Fjgarc75-beep/Felix/docs/presentacion/presentacion-proyecto.pptx

## Monitor experimental de frecuencia cardiaca y SpO₂ mediante señal PPG

Maestría en Ingeniería Clínica · Sistemas de Información Hospitalaria

ESP32 · MAX30102 · TFT ST7735 de 1.8"

[Autor] · [Institución]
[Profesor] · [Fecha de presentación]

Firmware Etapa9.ino · MD5 4d70eb1aef89be2d7ab61ec6d39b9f12

Prototipo académico · No es un dispositivo médico

Notes: Figura sugerida: fotografía del prototipo armado sobre la mesa, con un dedo sobre el sensor y la pantalla encendida (pendiente: F5).

Guion (≈ 30 s): Buenos días. Les presento el monitor experimental de frecuencia cardiaca y SpO₂ que desarrollé para la materia de Sistemas de Información Hospitalaria. Es un prototipo académico construido con un ESP32, un sensor óptico MAX30102 y una pantalla TFT de 1.8 pulgadas. Quiero dejar claro desde el inicio que no es un dispositivo médico: el objetivo es entender y verificar la cadena completa de un monitor de pulso, no sustituir a uno clínico. La versión que voy a describir es el firmware de la Etapa 9, identificado por su MD5.

## Problema

CONTEXTO

- Un oxímetro comercial entrega un número, pero no muestra cómo lo obtuvo ni cuándo deja de ser confiable.
- La señal óptica cambia con el tejido, la presión del dedo y el movimiento.
- El FIFO del sensor guarda solo ≈ 320 ms de datos: la pantalla no puede bloquear la lectura.
- Si el sensor deja de responder, la pantalla puede quedarse con valores congelados.

Pregunta del proyecto

¿Cómo obtener BPM y SpO₂ de una señal PPG y ocultarlos cuando no son confiables?

Notes: Figura sugerida: recuadro con la pregunta del proyecto (incluido); opcional, foto de un oxímetro comercial junto al prototipo.

Guion (≈ 40 s): Un oxímetro comercial es una caja cerrada: da un número, pero no deja ver cómo lo calculó ni cuándo deja de ser confiable. Para un ingeniero clínico, entender esa cadena es la base para evaluar equipos y reconocer artefactos. El problema tiene cuatro partes: obtener una señal óptica limpia, que cambia con el tejido y el movimiento; calcular el BPM y la SpO₂; mostrarlos sin interrumpir la lectura, porque el sensor solo guarda unos 320 milisegundos de datos; y detectar cuándo el sensor falla para no mostrar valores congelados. La pregunta del proyecto resume esto: cómo obtener los valores y ocultarlos cuando no son confiables.

## Justificación

CONTEXTO

- Hace visible cada paso de un monitor de pulso: luz, señal, pulso, R y valor final.
- Trata la calidad del dato y su estado de validez: válido, estabilizando o sin señal.
- Usa componentes de bajo costo y un firmware trazable, repetible con fines docentes.

1. Dispositivo

Genera el dato: este prototipo

2. Dato con estado

Valor, calidad y validez: este prototipo

3. Sistema de información

Registro e interoperabilidad: trabajo futuro

Notes: Figura sugerida: cadena de tres bloques "dispositivo → dato con estado → sistema de información" (incluida; el tercer bloque, punteado, no está implementado).

Guion (≈ 40 s): ¿Por qué hacerlo? Primero, porque hace visibles los pasos que un monitor comercial oculta: la luz, la señal, el pulso, la razón R y el valor final. Segundo, porque obliga a tratar la calidad del dato y su estado de validez, algo central en un sistema de información hospitalaria: un valor sin estado no sirve para un registro clínico. Tercero, porque es barato y repetible. En la cadena de información, este prototipo cubre los dos primeros eslabones: genera el dato y le asigna un estado. El tercero, enviarlo a un sistema de información, no está implementado y lo presento como trabajo futuro.

## Objetivos

CONTEXTO

General: adquirir la PPG roja e infrarroja, estimar BPM y una SpO₂ experimental, evaluar la calidad y mostrarlo todo en la TFT, ocultando lo que no sea confiable.

Objetivo específico | Estado de verificación
Adquirir RED e IR a ≈ 100 muestras/s sin pérdidas | Hardware, Etapa 4.1
Filtrar la PPG entre 0.5 y 5 Hz | Hardware, Etapa 4.1
Calcular un BPM estable con estados de validez | Inferido de la 6.2; H5 pendiente
Calcular R y una SpO₂ experimental | Hardware, sin referencia clínica
Mostrar valores y gráfica sin afectar la lectura | Hardware 7.3; gráfica pendiente
Robustez P1–P4 y pruebas automatizadas | Simulación; hardware pendiente

Notes: Figura sugerida: tabla de objetivos con su estado de verificación (incluida).

Guion (≈ 45 s): El objetivo general es adquirir la señal PPG roja e infrarroja, estimar el BPM y una SpO₂ experimental, evaluar la calidad y mostrar todo en la pantalla, ocultando lo que no sea confiable. Lo dividí en objetivos específicos, y a la derecha indico cómo se verificó cada uno, porque no todos tienen el mismo nivel de evidencia. La adquisición y el filtrado se validaron en el hardware. La SpO₂ también se probó en el hardware, pero solo contra criterios internos, sin un oxímetro de referencia. La robustez de la Etapa 9 solo se ha probado en simulación; sus pruebas físicas están pendientes.

## Arquitectura del sistema

SISTEMA

Diagrama de arquitectura del sistema

- Sensor → ESP32 por I²C a 400 kHz; ESP32 → TFT por SPI a 16 MHz.
- Seis bloques de firmware en un solo lazo, sin bloqueos.
- La computadora solo envía comandos y lee diagnósticos (115200 baudios, 22 comandos).
- Alimentación de 3.3 V de la tarjeta; condensador de 470 µF / 25 V.

Notes: Figura sugerida: diagrama de bloques sensor → ESP32 → TFT con la computadora por USB (incluido; es el mismo del capítulo 12 de la documentación técnica).

Guion (≈ 45 s): La arquitectura es sencilla. El sensor MAX30102 tiene dos LED, rojo e infrarrojo, un fotodiodo y un convertidor de 18 bits; guarda las muestras en un FIFO de 32. El ESP32 lo lee por I²C a 400 kilohertz y hace todo el trabajo en seis bloques: adquisición cada 10 milisegundos, procesamiento PPG, detección de pulsos, cálculo de R y SpO₂, calidad e interfaz, y la vigilancia que agregué en la Etapa 9. La pantalla recibe los datos por SPI a 16 megahertz. La computadora solo se usa para enviar comandos y leer diagnósticos por el Monitor Serie; no participa en la medición.

## Hardware

SISTEMA

Componente | Modelo | Función | Interfaz | Alimentación
Microcontrolador | ESP32-WROOM-32 | Adquisición, procesamiento, interfaz | USB, I²C, SPI | USB de la tarjeta (por confirmar)
Sensor óptico | MAX30102 | Señales PPG roja e infrarroja | I²C 0x57, 400 kHz | 3.3 V (VIN)
Pantalla | TFT 1.8", ST7735S, INITR_BLACKTAB | Valores, calidad y gráfica | SPI 16 MHz | 3.3 V (VCC y LED)
Condensador | Electrolítico 470 µF / 25 V | Reserva de carga | — | Punto de conexión por confirmar

- Sin pin INT ni microSD: el FIFO se lee por sondeo cada 10 ms.
- Todo trabaja a 3.3 V: no hacen falta convertidores de nivel.
- WiFi, Bluetooth, alarmas y registro no forman parte del prototipo.

Notes: Figura sugerida: fotografía de los tres módulos sobre la protoboard con sus etiquetas (pendiente: F5).

Guion (≈ 40 s): El hardware son tres módulos y un condensador. El ESP32-WROOM-32 hace todo el procesamiento. El MAX30102 es el sensor óptico, en la dirección I²C 0x57. La pantalla es una TFT de 1.8 pulgadas con controlador ST7735, que en mi módulo requiere la variante BLACKTAB. Hay un condensador electrolítico de 470 microfaradios como reserva de carga; el punto exacto donde está conectado lo tengo pendiente de documentar. Todo trabaja a 3.3 volts. No uso el pin de interrupción del sensor ni la microSD, y el prototipo no tiene WiFi, Bluetooth, alarmas ni registro.

## Diagrama de conexiones

SISTEMA

Diagrama de conexiones del prototipo

Atención con “SDA”

En el MAX30102, SDA son datos I²C (GPIO21). En la TFT, el pin rotulado SDA es MOSI del bus SPI (GPIO23).

- INT y RD del sensor van sin conectar.
- Las mismas conexiones están en la cabecera del firmware (L35–41).

Notes: Figura sugerida: esquema de cableado con colores por bus (I²C en un color, SPI en otro) o fotografía del cableado real (pendiente: F5).

Guion (≈ 40 s): Estas son las conexiones reales. El sensor va al bus I²C: alimentación de 3.3 volts, tierra, SDA al GPIO21 y SCL al GPIO22; INT y RD quedan sin conectar. La pantalla va al bus SPI: reloj al GPIO18, datos al GPIO23, A0 al 16, reset al 17 y chip select al 5, con VCC y la retroiluminación a 3.3 volts. Un detalle que confunde a cualquiera que arme el circuito: los dos módulos tienen un pin llamado SDA, pero no son lo mismo. En el sensor es la línea de datos de I²C; en la pantalla es la salida de datos de SPI, es decir, MOSI. Las mismas conexiones están escritas en la cabecera del firmware.

## MAX30102 y señal PPG

ALGORITMOS

- Reflexión: LED y fotodiodo del mismo lado; el dedo se apoya encima.
- DC: tejido y sangre no pulsátil. AC: volumen arterial de cada latido.
- Rojo ≈ 660 nm e infrarrojo ≈ 880 nm: la hemoglobina absorbe distinto.
- 400 muestras/s internas y promedio de 4: 100 muestras/s nominales.

99.1 /s

muestras medidas, 0 pérdidas (Etapa 4.1, hardware)

830 / 293

cuentas de AC pico a pico, IR y rojo

55.4×

AC con dedo frente a sin dedo

Notes: Figura sugerida: captura del Serial Plotter (modo k o g) con la onda PPG IR y roja del prototipo real (pendiente: F5); los tres datos de la derecha son resultados medidos en la Etapa 4.1.

Guion (≈ 45 s): El MAX30102 trabaja por reflexión: el LED y el fotodiodo están del mismo lado y el dedo se apoya encima. La luz que regresa tiene una parte casi constante, la DC, que viene del tejido y de la sangre que no pulsa, y una parte que oscila con cada latido, la AC. Usamos dos colores, rojo e infrarrojo, porque la hemoglobina oxigenada y la desoxigenada absorben distinto en cada uno. El sensor muestrea a 400 por segundo y promedia de cuatro en cuatro. En la Etapa 4.1 medimos 99.1 muestras por segundo sin pérdidas. El infrarrojo dio casi tres veces más amplitud que el rojo, y la señal con dedo fue 55 veces mayor que sin dedo.

## Procesamiento de señal

ALGORITMOS

Cadena de procesamiento de la señal

- Un escalón mayor al 10 % del DC o a 5000 cuentas reinicia los filtros.
- Luego hay 2 s de estabilización: 1 s de DC rápido y 1 s de calentamiento.
- RED e IR se procesan y se reinician juntos, para que sigan alineados.
- En PC, los filtros coinciden con scipy: coeficientes (error ≤ 1e-5) y salida (error relativo ≤ 1e-4).

Notes: Figura sugerida: cadena de filtrado (incluida, a la izquierda) y, opcional, la respuesta en frecuencia de los dos filtros calculada con scipy.

Guion (≈ 45 s): Cada muestra recorre la misma cadena. Primero se resta la componente DC, que se estima con una constante de tiempo de un segundo. Después pasa por un pasa-altas de 0.5 hertz, que atenúa la deriva lenta, y un pasa-bajas de 5 hertz, que quita el ruido; ambos son Butterworth de segundo orden. El resultado es la componente AC; la invertimos para que el pico sistólico quede hacia arriba. Si hay un escalón brusco, por ejemplo al poner o quitar el dedo, los filtros se reinician y hay dos segundos de estabilización. En las pruebas en PC, los coeficientes coincidieron con los de scipy con un error menor a una cienmilésima, y la salida de los filtros con un error relativo menor a una diezmilésima.

## Cálculo de BPM

ALGORITMOS

- Umbral: 50 % de una envolvente que cae con τ = 2 s.
- Prominencia: el pico sube ≥ 50 % de la envolvente sobre su valle.
- Refractario: el mayor entre 300 ms y 60 % del intervalo medio.
- Intervalo aceptado: 40–180 BPM y ±30 % de la mediana.
- BPM = 60000 / media de hasta 8 intervalos aceptados.

SIN SEÑAL

sin dedo, saturación o señal débil

ESTABILIZANDO

acumulando pulsos consistentes

BPM VÁLIDO

5 aceptados seguidos y CV ≤ 20 %

Notes: Figura sugerida: captura del Serial Plotter en modo k (PPG, umbral y picos detectados) del prototipo real (pendiente: F5); a la derecha, los tres estados del BPM (incluidos).

Guion (≈ 50 s): Para detectar pulsos uso tres criterios. Primero, un umbral adaptativo: la mitad de una envolvente que sigue la amplitud de la señal. Segundo, la prominencia: el pico tiene que subir al menos la mitad de la envolvente desde el valle de su propio ciclo; así se descarta la muesca dicrótica. Tercero, un periodo refractario. Cada intervalo se acepta solo si está entre 40 y 180 BPM y no se aleja más de 30 % de la mediana reciente. El BPM mostrado es 60000 entre la media de hasta ocho intervalos. Y solo se muestra en el estado BPM VÁLIDO, que exige cinco intervalos aceptados seguidos con poca variación. La exactitud frente a un conteo manual, la prueba H5, está pendiente.

## Estimación de SpO₂

ALGORITMOS

Razón por latido (regresión RED–IR)

R = [cov(AC rojo, AC IR) / var(AC IR)] · DC IR / DC rojo
Equivale a la razón de razones (AC/DC rojo) ÷ (AC/DC IR).

Curva genérica de Maxim

SpO₂ = −45.060 R² + 30.354 R + 94.845

- Cinco criterios por latido: PI IR ≥ 0.2 %, AC rojo ≥ 50, correlación ≥ 0.80, |Rpp − Rrms| ≤ 15 %, ΔDC ≤ 5 %.
- R útil entre 0.34 y 1.15; se muestra la mediana de hasta 8 R válidos (mínimo 5, CV ≤ 10 %).
- Estados: SIN SEÑAL, ESTABILIZANDO, CALIDAD INSUFICIENTE, FUERA DE RANGO y VÁLIDA.

Coeficientes genéricos, sin calibrar: es una estimación experimental, no una medición clínica validada.

Notes: Figura sugerida: la curva R → SpO₂ entre R = 0.34 y 1.15, marcando el valor medido R ≈ 0.375 (Etapa 6.2) en la zona casi plana.

Guion (≈ 55 s): Para la SpO₂, en cada latido aceptado calculo la razón R: la pulsatilidad relativa del rojo entre la del infrarrojo. El estimador principal es una regresión entre las dos señales en todo el latido, porque es menos sensible al ruido que el pico a pico; el pico a pico y el RMS quedan como verificación cruzada. Cada latido tiene que cumplir cinco criterios de calidad y dar un R entre 0.34 y 1.15. Se muestra la mediana de los últimos ocho R válidos, y solo si hay al menos cinco y varían menos de 10 %. La conversión usa la curva genérica de Maxim. Y aquí está el punto más importante de la presentación: esos coeficientes no están calibrados para este módulo, así que el número es una estimación experimental, no una medición clínica.

## Interfaz TFT

INTERFAZ

- Distribución B: BPM, SpO₂ con un decimal, calidad, gráfica y pie.
- Estados revisados cada 250 ms; cada campo se redibuja como máximo cada 500 ms.
- Sin borrar la pantalla durante la medición: peor caso ≈ 18.3 ms (Etapa 7.3).
- Calidad: BUENA, REGULAR, MALA, SIN DEDO o BUSCANDO.
- Al encender: aviso de 3 s “NO ES DISPOSITIVO MEDICO”.

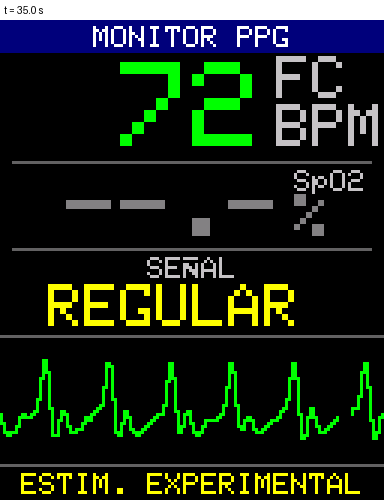
[picture p5: figure]
Pantalla simulada en PC

Simulación en PC (Etapa 8.2); valores ilustrativos, no medidos

Notes: Figura sugerida: fotografía real de la pantalla en cada estado de calidad (pendiente: F5, prueba H7). La imagen de la derecha es una pantalla simulada en PC (Etapa 8.2): muestra la distribución y sus valores son ilustrativos, no medidos.

Guion (≈ 45 s): La pantalla es de 128 por 160 píxeles y usa la distribución B: arriba el BPM en verde, después la SpO₂ con un decimal en cian, luego la calidad de la señal, la onda PPG y un pie que dice "estimación experimental". Para no interrumpir la lectura del sensor, la pantalla nunca se borra completa durante la medición: los estados se revisan cada 250 milisegundos y cada campo se redibuja como máximo dos veces por segundo, solo si cambió. En la Etapa 7.3 el peor caso de dibujo fue de unos 18 milisegundos. Al encender aparece durante tres segundos el aviso de que no es un dispositivo médico.

## Gráfica PPG en tiempo real

INTERFAZ

- Lee el búfer que ya existe para R: no hace otra adquisición.
- 4 muestras por columna: ≈ 25 columnas/s y ≈ 5.1 s por pantalla.
- Escala automática: crece rápido, se reduce despacio, mínimo 40 cuentas.
- Verde con BUENA o REGULAR, gris con BUSCANDO o MALA, plana sin dedo.
- Se corta si hay muestras perdidas; el comando l la activa o desactiva.

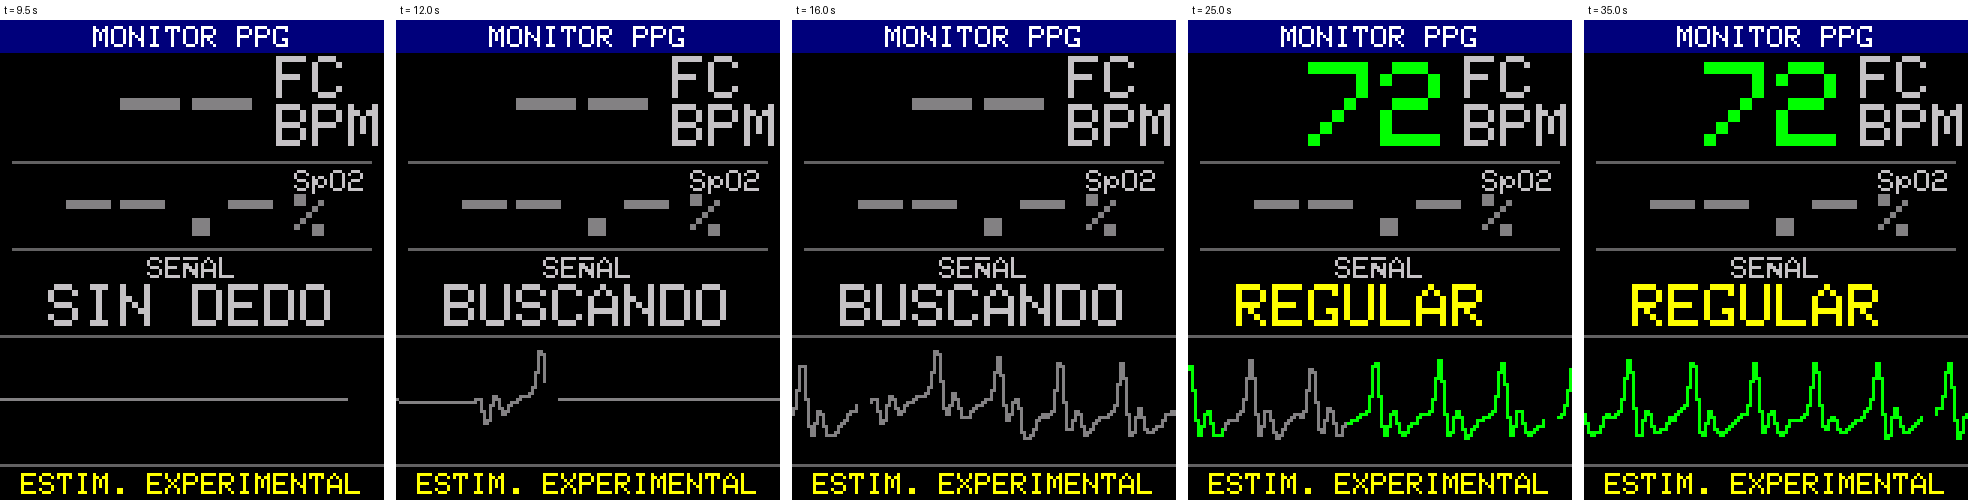
[picture p6: figure]
Secuencia de pantallas simuladas

142 µs

por columna de onda, medido en la Etapa 7.1 (hardware)

H8 y H9

barrido real e interacción SPI–I²C: pendientes de ejecución

Simulación en PC (Etapa 8.2): SIN DEDO → BUSCANDO → REGULAR

Notes: Figura sugerida: video corto de la gráfica barriendo la pantalla real con el dedo puesto (pendiente: F5, prueba H8).

Guion (≈ 40 s): La gráfica PPG se agregó en la Etapa 8.2 con una regla: no hacer otra adquisición. Lee el mismo búfer que ya existía para calcular R. Promedia cuatro muestras por columna, así que avanza unas 25 columnas por segundo y recorre la pantalla en unos cinco segundos. La escala se ajusta sola: crece de inmediato si la señal aumenta y se reduce despacio para no saltar. El color indica la calidad: verde cuando es buena o regular, gris cuando se está buscando, y una línea plana cuando no hay dedo. Dibujar una columna tomó 142 microsegundos en la Etapa 7.1, pero la velocidad real del barrido en la versión actual todavía está pendiente de medir.

## Robustez P1–P4

ROBUSTEZ · ETAPA 9

P1 · 1 s

Sin muestras: oculta valores y muestra SENSOR NO RESPONDE

P2 · 3 s

Reinicializa el sensor sin reiniciar el ESP32

P3 · arranque

Separa pérdidas de arranque y de operación

P4 · tiempos

Sumas de 64 bits y tramos de diagnóstico con z

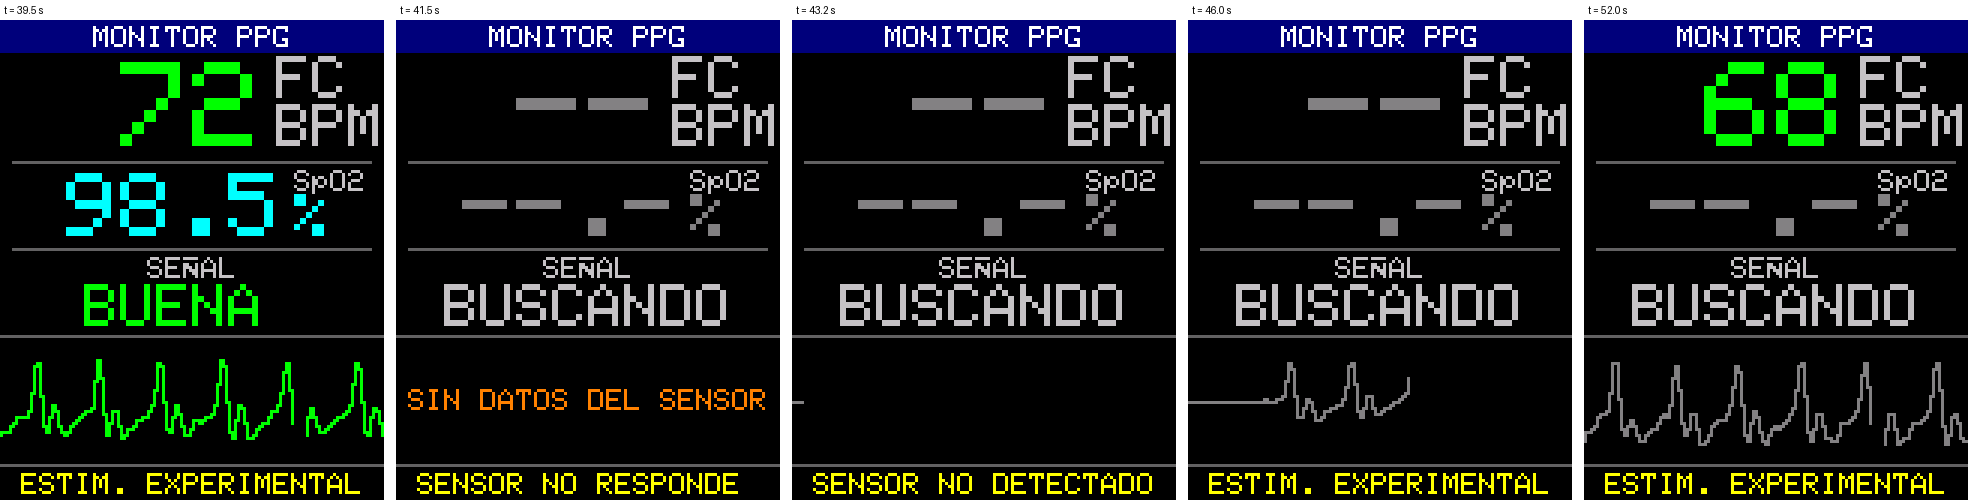
[picture p7: figure]
Secuencia simulada de falla y recuperación del sensor

Simulación en PC, no hardware: normal → NO RESPONDE → NO DETECTADO → recuperado → BPM de nuevo

Notes: Figura sugerida: secuencia de pantallas de la falla del sensor (incluida; es una simulación en PC). Para la entrega final, sustituir o acompañar con fotos reales de la prueba H10 (pendiente).

Guion (≈ 55 s): La Etapa 9 resolvió un problema que antes pasaba inadvertido: si el sensor dejaba de enviar muestras, la pantalla se quedaba con el último BPM y la última SpO₂, como si siguieran vigentes. Agregué cuatro mejoras sin tocar los algoritmos validados. P1: si pasa un segundo sin muestras, se ocultan los valores y aparece "SENSOR NO RESPONDE". P2: a los tres segundos se reinicializa el sensor, sin reiniciar el microcontrolador. P3 registra el arranque por separado, para saber si las pérdidas ocurren al encender o durante la operación. P4 usa sumas de 64 bits para pruebas largas. La imagen muestra la secuencia, pero es una simulación en PC: la prueba física H10, desconectando el cable de datos, está pendiente.

## Metodología de pruebas

PRUEBAS · ETAPA 10

1 · Unitarias en PC

45 funciones puras o deterministas contra referencias en Python

Ejecutadas: 116/116

2 · Integración en PC

Simulador del sensor y de la TFT; 109 funciones y 17 flujos

Pendiente de ejecución

3 · Hardware

14 pruebas físicas H0–H13 con el ESP32, el sensor y la TFT

Pendiente de ejecución

- Ninguna prueba modifica Etapa9.ino: el MD5 se verifica antes y después.
- Se compila con el mismo preprocesador del IDE de Arduino.
- Cobertura gcov ≥ 85 %: objetivo, no criterio de aprobación.

Notes: Figura sugerida: los tres niveles de prueba con su estado (incluidos); opcional, la salida en consola de run_tests.sh.

Guion (≈ 45 s): El plan de pruebas de la Etapa 10 tiene tres niveles. El primero son pruebas unitarias en la computadora: las 45 funciones de cálculo, comparadas con valores que calculé por separado en Python. Ese nivel ya está ejecutado y aprobaron los 116 casos. El segundo son pruebas de integración en la computadora, con simuladores del sensor y de la pantalla; están definidas pero pendientes. El tercero son 14 pruebas físicas con el hardware real, también pendientes. Hay dos reglas: ninguna prueba modifica el firmware, y lo compruebo con el MD5 antes y después; y la cobertura de 85 % es un objetivo, no un requisito para aprobar.

## Resultados

RESULTADOS

Prueba | Tipo | Resultado | Estado
Señal PPG (t), Etapa 4.1 | Hardware | 99.1 muestras/s, 0 pérdidas, correlación 0.98, 55.4× | Aprobada
SpO₂ (w), Etapa 6.2 | Hardware | 35 latidos, R ≈ 0.375, CV ≈ 4 %, SpO₂ ≈ 99.9 % | Con observaciones
TFT, Etapas 7.1–7.3 | Hardware | Peor caso de dibujo ≈ 18.3 ms; 5 min estables | Aprobada
Integración, Etapa 7.3 | Hardware | Errores I²C iniciales; luego 14 pérdidas y 1 desbordamiento | Con observaciones
Categoría 1 | PC (simulación) | 116/116 casos; 100 % de líneas y ramas; 16/16 mutantes | Aprobada
Etapa 9, H0–H13 | Hardware | — | Pendiente de ejecución

Los resultados de PC son simulación y no sustituyen a las pruebas físicas de la versión actual.

Notes: Figura sugerida: tabla de resultados con el tipo de evidencia (incluida); opcional, la curva R→SpO₂ con el punto R ≈ 0.375 para explicar la observación de la Etapa 6.2.

Guion (≈ 60 s): Estos son los resultados reales, separados por tipo. En hardware, la prueba de señal de la Etapa 4.1 dio 99.1 muestras por segundo, sin pérdidas, con una correlación entre rojo e infrarrojo de 0.98. La prueba de SpO₂ de la 6.2 dio 35 latidos válidos, con R estable, CV de 4 %, pero una SpO₂ media de 99.9 %. Ese valor está en la zona plana de la curva y sugiere que la curva sobreestima para este módulo; por eso lo marco con observaciones. La pantalla dibuja en unos 18 milisegundos en el peor caso. En la 7.3 hubo errores I²C al principio y quedaron 14 pérdidas acumuladas cuyo origen está pendiente. En PC, la Categoría 1 aprobó completa. Y lo más importante: la versión actual, la Etapa 9, todavía no tiene pruebas físicas.

## Lo que este prototipo no es

LIMITACIONES

- No es un dispositivo médico certificado ni sustituye a un monitor clínico.
- La SpO₂ no tiene validación clínica: curva genérica, sin oxímetro de referencia.
- La exactitud clínica no se demostró, ni de la SpO₂ ni del BPM.
- No debe usarse para diagnóstico ni para decisiones de salud.
- Técnicas: Etapa 9 sin pruebas físicas; filtros con fs nominal; sin alarmas ni registro.

El proyecto se centra en la adquisición, el procesamiento, la visualización y la validación experimental.

Notes: Figura sugerida: ninguna; es una diapositiva de declaración.

Guion (≈ 45 s): Quiero ser explícito con las limitaciones. Este prototipo no es un dispositivo médico certificado y no sustituye a un monitor clínico. La SpO₂ no tiene validación clínica: la curva es genérica y no la comparé con un oxímetro de referencia. Por lo tanto, la exactitud clínica no está demostrada, ni para la SpO₂ ni para el BPM, y el equipo no debe usarse para diagnóstico. En lo técnico, la versión actual no tiene pruebas físicas, los filtros usan la frecuencia nominal y no hay alarmas ni registro. El valor del proyecto está en la adquisición, el procesamiento, la visualización y la validación experimental.

## Conclusiones

CIERRE

- Se construyó la cadena completa, del sensor a la pantalla, con un firmware trazable de 154 funciones.
- La adquisición y la señal PPG quedaron validadas en hardware en la Etapa 4.1: 99.1 muestras/s y 0 pérdidas.
- R es estable en reposo (CV ≈ 4 %), pero la SpO₂ que se calcula con ella sigue siendo experimental.
- La interfaz no compromete la adquisición y oculta los valores que no son confiables.
- El proyecto no está completamente validado: faltan las pruebas físicas de la Etapa 9.

Notes: Figura sugerida: fotografía final del prototipo funcionando (pendiente: F5).

Guion (≈ 45 s): Para cerrar. Construí la cadena completa de un monitor de pulso, del sensor a la pantalla, con un firmware de 154 funciones en el que cada capacidad se puede rastrear hasta su línea de código. La adquisición y la señal PPG quedaron validadas en el hardware. La razón R es estable en reposo, pero la SpO₂ que se deriva de ella sigue siendo una estimación experimental. La pantalla no interfiere con la lectura y, sobre todo, oculta los valores cuando no son confiables. Y, con honestidad: el proyecto no está completamente validado, porque las pruebas físicas de la versión actual siguen pendientes.

## Trabajo futuro

CIERRE

Cerrar la validación

• Ejecutar H0–H13 en hardware
• Integración en PC: 2a–2g y E1–E17

Mejorar la medición

• Calibrar la curva con un oxímetro de referencia
• Filtros con la fs medida y corriente de LED automática

Integrar al hospital

• Enviar valor, calidad y estado a un sistema de información
• Interoperabilidad, por ejemplo HL7 FHIR

Cualquier cambio de firmware implica nueva versión, nuevo MD5 y nueva validación.

Notes: Figura sugerida: tres columnas de trabajo futuro (incluidas).

Guion (≈ 40 s): El trabajo futuro tiene tres líneas. La primera es cerrar la validación: ejecutar las 14 pruebas físicas y las pruebas de integración en la computadora. La segunda es mejorar la medición: calibrar la curva de SpO₂ contra un oxímetro de referencia, recalcular los filtros con la frecuencia medida y controlar la corriente de los LED automáticamente. La tercera conecta con la materia: enviar el valor, su calidad y su estado a un sistema de información hospitalaria, por ejemplo con HL7 FHIR, que hoy no está implementado. Cualquiera de estos cambios exigiría una nueva versión del firmware y repetir su validación.

## Preguntas

Documentación técnica, manual de usuario, plan de pruebas y expediente de evidencias disponibles para revisión.

[Autor] · [Correo institucional]

Notes: Figura sugerida: ninguna; opcional, tener el prototipo encendido en la mesa para una demostración.

Guion (≈ 15 s): Muchas gracias. Con esto termino. La documentación técnica, el manual de usuario, el plan de pruebas y el expediente de evidencias están disponibles para su revisión. Quedo atento a sus preguntas.

Preguntas probables y respuesta corta:
1) ¿Qué tan exacta es la SpO₂? No se ha demostrado; no hubo oxímetro de referencia y la curva es genérica.
2) ¿Por qué 99.9 %? R ≈ 0.375 cae en la zona plana de la curva; el firmware advierte que probablemente sobreestima.
3) ¿Qué pasa si se mueve el dedo? Un escalón reinicia los filtros; el BPM vuelve a ESTABILIZANDO y no se muestra un valor dudoso.
4) ¿Qué falta para validarlo? Las 14 pruebas físicas H0–H13 y las de integración en PC.
