Fjgarc75-beep/Felix/docs/evidencias/simulaciones/simulacion_pantallas_7_3.png

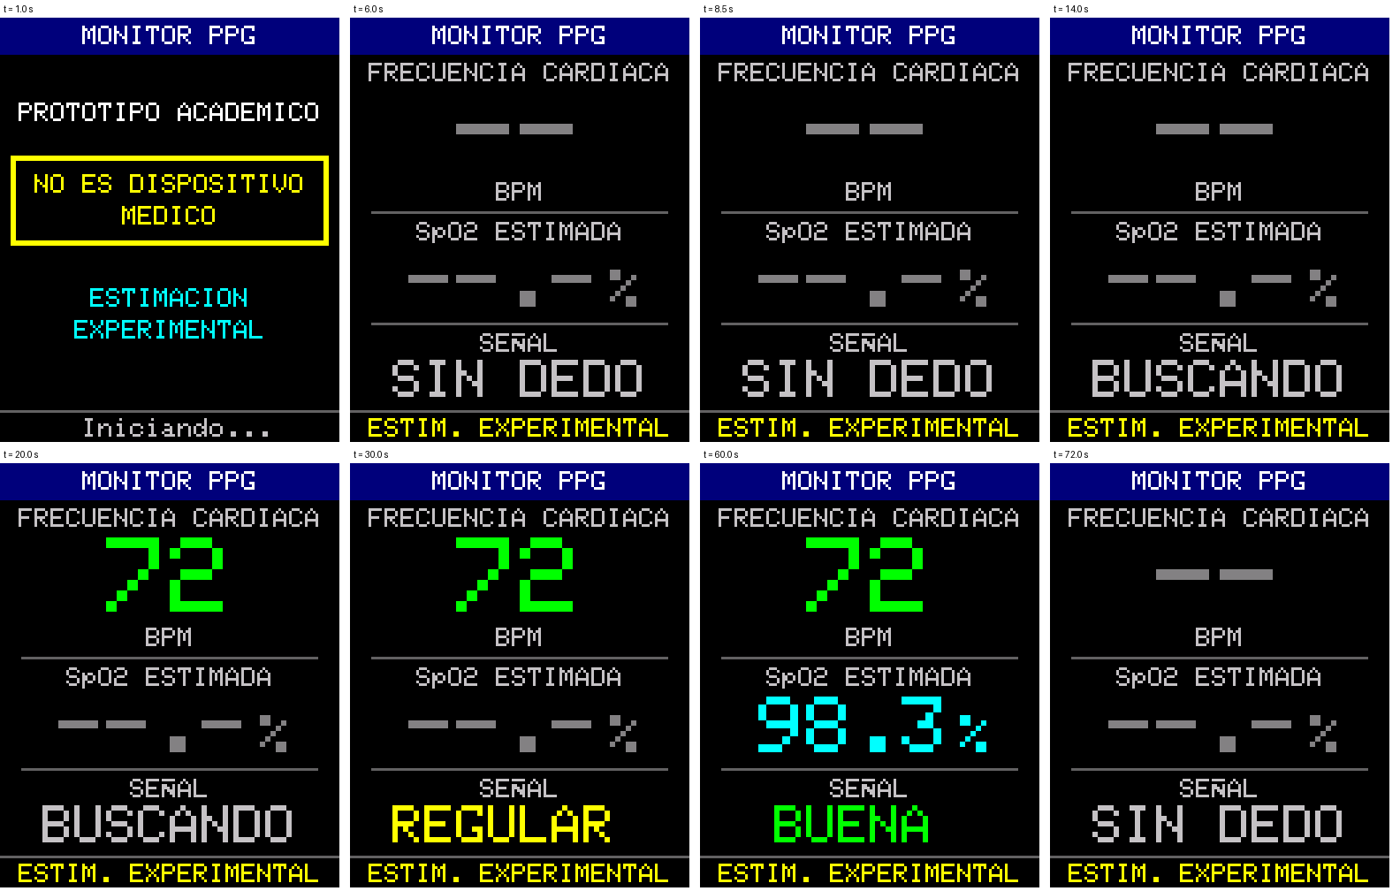
docs/evidencias/simulaciones/simulacion_pantallas_7_3.png
