Fjgarc75-beep/Felix/docs/evidencias/simulaciones/simulacion_pantallas_8_2.png

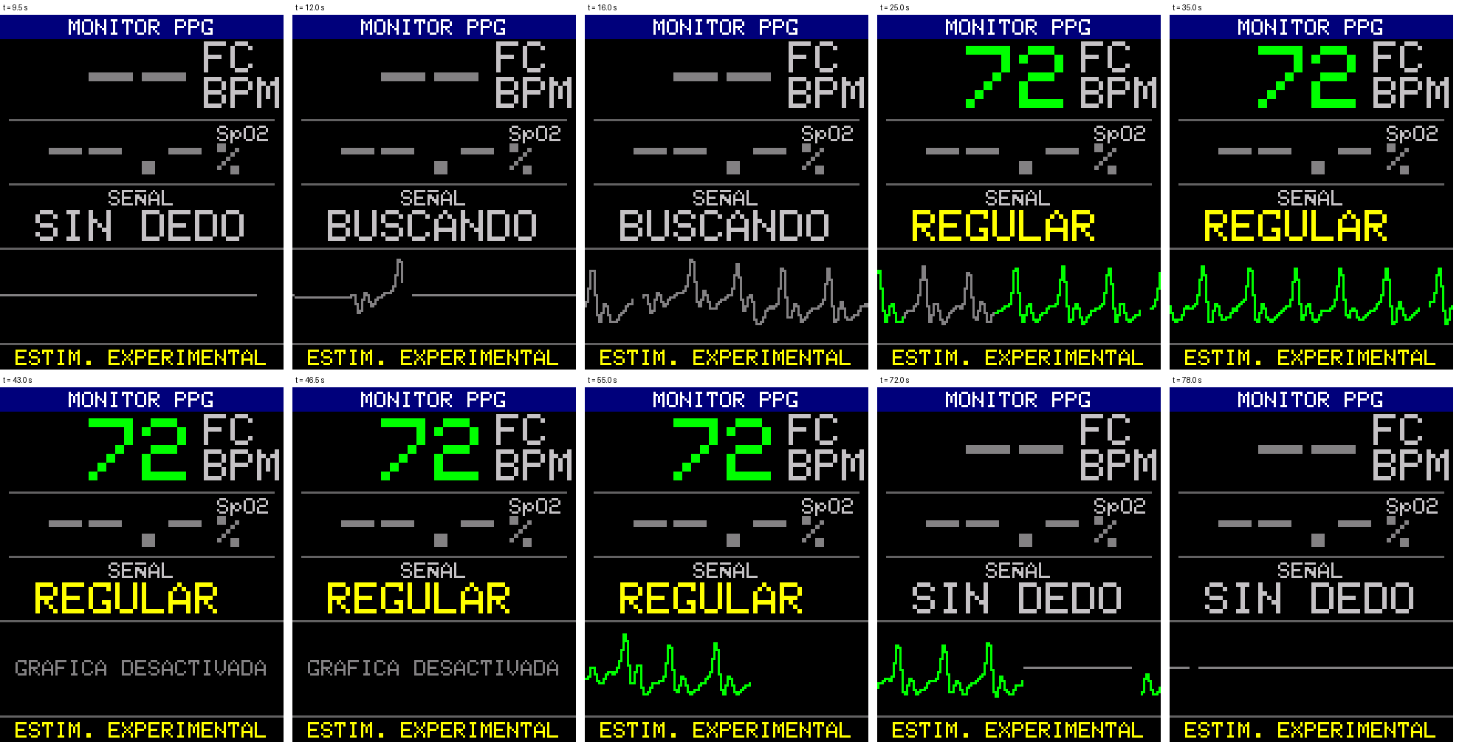
docs/evidencias/simulaciones/simulacion_pantallas_8_2.png
