Fjgarc75-beep/Felix/docs/pruebas/resultados-pruebas.md

# Resultados de pruebas

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

Este documento separa **resultados físicos** (ESP32, MAX30102 y TFT reales, reportados por el autor), **resultados simulados en PC** y **pruebas pendientes de ejecución**. No se marca ninguna prueba como aprobada sin evidencia. La cobertura gcov ≥ 85 % es un **objetivo**, no un criterio de aprobación, salvo instrucción explícita posterior del profesor.

| Clase | Significado |
| --- | --- |
| A | Ejecutada y aprobada |
| B | Ejecutada con observaciones |
| C | Pendiente de ejecución |
| D | No aplicable o fuera de alcance |
| E | Resultado simulado en PC |
| F | Resultado obtenido físicamente sobre el ESP32 |

## 1. Resultados disponibles por clase

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

### F) Resultados obtenidos físicamente (ESP32 + MAX30102 + TFT reales)

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

### E) Resultados simulados en PC

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

### D) No aplicables o fuera de alcance

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

## 2. Resumen y detalle de resultados

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

### 2.1 Resumen de pruebas

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

### 2.2 Resultados físicos en detalle

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

**Pantalla, etapas 7.1 a 7.3.**

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

## 3. Pruebas unitarias en PC (Categoría 1)

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

Reporte completo: [`tests/unitarias/REPORTE_Categoria1.md`](../../tests/unitarias/REPORTE_Categoria1.md).

## 4. Pruebas de integración en PC

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

## 5. Pruebas sobre hardware (Etapa 9)

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

## 6. Pruebas pendientes

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

Pruebas de hardware que deciden la validación de la Etapa 9 (todas pendientes de ejecución):

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

## 7. Análisis de resultados

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
