Fjgarc75-beep/Felix/(commit log)

2026-10-09 docs: add technical documentation, presentation and user manual
    Publica la documentación del monitor experimental de FC, SpO2 y PPG
    (ESP32 + MAX30102 + TFT ST7735), con el firmware de referencia
    Etapa9.ino (MD5 4d70eb1aef89be2d7ab61ec6d39b9f12, sin modificar).
    - docs/: documentación técnica, manual de usuario, presentación (.pptx con
    notas y guion oral), plan, resultados y matriz de trazabilidad de la
    Etapa 10, inventario documental, expediente de evidencias, limitaciones
    y seguridad, y 5 diagramas (PNG y SVG).
    - firmware/: copia de la línea base Etapa 9 con sus diffs e historial de
    las etapas 1 a 8.2.
    - hardware/: componentes, conexiones y lista de materiales.
    - tests/: prueba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
    [cat1_cobertura.csv, cat1_lineas_no_cubiertas.csv, cat1_ramas_no_cubiertas.csv, cat1_resultados.csv, cat1_variante_dec0_resultados.csv]
2026-10-10 docs: add PDF versions of technical documentation and user manual
    - docs/pdf/documentacion-tecnica.pdf (40 páginas, A4) y
    docs/pdf/manual-usuario.pdf (9 páginas, A4), generados desde los
    Markdown del repositorio, con diagramas y ecuaciones.
    - Enlaces a los PDF en el README y entrada en el CHANGELOG.
    Firmware sin cambios (MD5 4d70eb1aef89be2d7ab61ec6d39b9f12).
    Claude-Session: https://claude.ai/code/session_013oHLFLabHq8SaQXP4AT7bu
